j-h-a/go-pro-mounts/(list of files, cad)

Other CAD files:
quickrelease_pole_grip.scad
quickrelease_clip.scad
