j-h-a/go-pro-mounts/(commit log)

2014-01-21 First stab at parts for the three-pronged connector.
    [simple_objects.scad, triprong_connector.scad]
2014-01-22 Split modules for mounting prongs into a separate file and use it for the three and two prong connectors.
    [biprong_connector.scad, mounting_prongs.scad]
2014-01-22 First attempt at thumb-screw.
    [thumbscrew_long.scad]
2014-01-22 Refine the long thumbscrew to fit 50mm M5 bolts.
    [thumbscrew_long.scad]
2014-01-25 First attempt at the quick-release base.
    [quickrelease_base.scad]
2014-01-28 Widen the clip width slightly and increase the interior height of the overhanging part to allow for the ‘spread’ of the filament when it prints, and so that less sanding is required.
    [quickrelease_base.scad]
2014-01-28 Separate the base-plate from the quick-release clip so that it can be re-used by other components.
    [quickrelease_base.scad, quickrelease_base_clip.scad]
2014-01-28 Add a pole-grip for the quick-release base clip.
    [quickrelease_base_pole_grip.scad]
2014-01-31 Tidy-up filenames and directory structure. Add images and documentation in the README.
    [connector_biprong.scad, connector_triprong.scad, quickrelease_clip.scad, quickrelease_pole_grip.scad, thumbscrew_long.scad]
2014-02-04 Update the modules for mounting prongs so that they are more flexible to passed-in values, and automatically correct some problems with different values.
    [connector_biprong.scad, connector_triprong.scad]
2014-02-04 Add a model for a flat connector (no 90 degree rotation like the official ones).
    [connector_flat.scad]
2014-02-04 Update the build instructions for the conncetors, also adding the flat connector section.
